skysdottir/Enemy-Within/motherboard hardware/production/bom.csv

Designator | Footprint | Quantity | Value | LCSC Part #
C1, C2, C20, C21, C22 | 0402 | 5 | 1uf
C10, C11, C12, C13, C6, C7, C8, C9 | 0603 | 8 | 47uF
C14, C15, C17, C19, C3 | 0402 | 5 | 100nF
C16 | 0402 | 1 | 10nF
C23, C4, C5 | 0402 | 3 | 10uF
D1 | 0603 | 1 | LED Red
D2 | 0603 | 1 | LED Blue
J2 | JST_XH_B6B-XH-A_1x06_P2.50mm_Vertical | 1 | Conn_01x06_Pin
J3 | MountingHole_2.2mm_M2_Pad_TopBottom | 1 | SMTSO1620MTJ
J4, J5 | PinHeader_1x02_P2.54mm_Vertical | 2 | Conn_01x02_Pin
J6, J8 | PinHeader_1x03_P2.54mm_Vertical | 2 | Conn_01x03_Pin
J7 | PinHeader_1x04_P2.54mm_Vertical | 1 | Conn_01x04_Pin
Q1, Q2, Q3 | DFN3x3A_8L_EP2_S_AOS | 3 | AON7934
R1, R2 | 0402 | 2 | 470R
R10, R13, R14, R7 | 0402 | 4 | 1k
R11, R12, R15, R4, R5, R6, R8, R9 | 0402 | 8 | 10k
R16, R17, R18, R19, R20, R21 | 0402 | 6 | 20r
R3 | 0402 | 1 | 100k
U1 | TSOT-23-5 | 1 | AP2204K-3.3
U2 | VQFN-20-1EP_3x3mm_P0.4mm_EP1.7x1.7mm | 1 | ATtiny1616-M
U3, U4 | WSON-8-1EP_2x2mm_P0.5mm_EP0.9x1.6mm | 2 | DRV8231
U5 | QFN-48-1EP_7x7mm_P0.5mm_EP3.5x3.5mm | 1 | STSPIN32F0ATR
