skysdottir/Enemy-Within/motherboard hardware/enemy-within-motherboard.kicad_pcb

## KiCad design motherboard hardware/enemy-within-motherboard.kicad_pcb (2026-01-28)

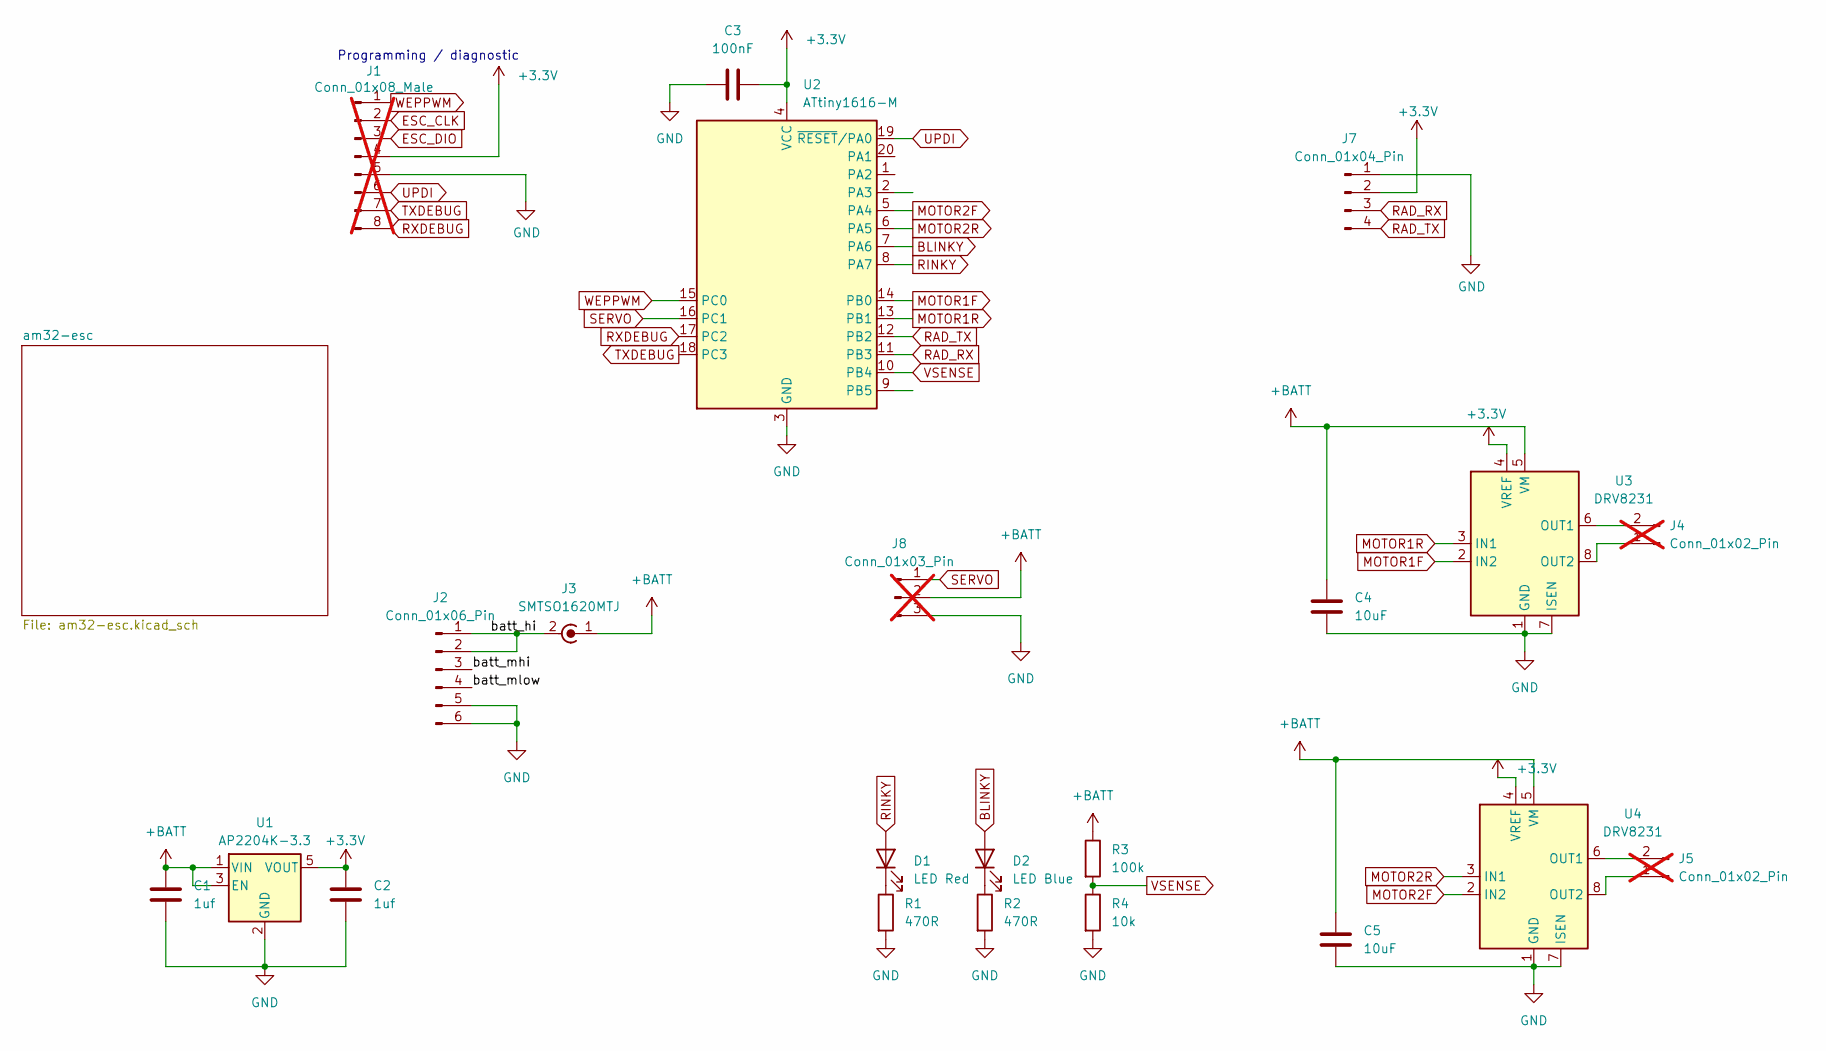
[picture p1: schematic enemy-within-motherboard.kicad_sch]

Parts:
C1, C2: 1uf; C_0402_1005Metric_Pad0.74x0.62mm_HandSolder
C3: 100nF; C_0402_1005Metric_Pad0.74x0.62mm_HandSolder
C4, C5: 10uF; C_0402_1005Metric_Pad0.74x0.62mm_HandSolder
D1: LED Red; LED_0603_1608Metric
D2: LED Blue; LED_0603_1608Metric
J1: Conn_01x08_Male; SOIC_clipProgSmall; not fitted
J2: Conn_01x06_Pin; JST_XH_B6B-XH-A_1x06_P2.50mm_Vertical
J3: SMTSO1620MTJ; MountingHole_2.2mm_M2_Pad_TopBottom
J4, J5: Conn_01x02_Pin; PinHeader_1x02_P2.54mm_Vertical; not fitted
J7: Conn_01x04_Pin; PinHeader_1x04_P2.54mm_Vertical
J8: Conn_01x03_Pin; PinHeader_1x03_P2.54mm_Vertical; not fitted
R1, R2: 470R; R_0402_1005Metric_Pad0.72x0.64mm_HandSolder
R3: 100k; R_0402_1005Metric_Pad0.72x0.64mm_HandSolder
R4: 10k; R_0402_1005Metric_Pad0.72x0.64mm_HandSolder
U1: AP2204K-3.3; TSOT-23-5
U2: ATtiny1616-M; VQFN-20-1EP_3x3mm_P0.4mm_EP1.7x1.7mm
U3, U4: DRV8231; WSON-8-1EP_2x2mm_P0.5mm_EP0.9x1.6mm

Connections:
+3.3V: C2.1, C3.2, J1.4, J7.2, U1.5 (VOUT), U2.4 (VCC), U3.4 (VREF), U4.4 (VREF); also elsewhere on the board
+BATT: C1.1, C4.1, C5.1, J3.1 (In), J8.2, R3.1, U1.1 (VIN), U1.3 (EN), U3.5 (VM), U4.5 (VM); also elsewhere on the board
/batt_hi: J2.1, J2.2, J3.2 (Ext)
/batt_mhi: J2.3
/batt_mlow: J2.4
BLINKY: D2.2 (A), U2.7 (PA6)
ESC_CLK: J1.2; also elsewhere on the board
ESC_DIO: J1.3; also elsewhere on the board
GND: C1.2, C2.2, C3.1, C4.2, C5.2, J1.5, J2.5, J2.6, J7.1, J8.3, R1.2, R2.2, R4.2, U1.2 (GND), U2.3 (GND), U2.21 (GND), U3.1 (GND), U3.7 (ISEN), U3.9 (GND), U4.1 (GND), U4.7 (ISEN), U4.9 (GND); also elsewhere on the board
MOTOR1F: U2.14 (PB0), U3.2 (IN2)
MOTOR1R: U2.13 (PB1), U3.3 (IN1)
MOTOR2F: U2.5 (PA4), U4.2 (IN2)
MOTOR2R: U2.6 (PA5), U4.3 (IN1)
unnamed: D1.1 (K), R1.1
unnamed: D2.1 (K), R2.1
unnamed: J4.1, U3.8 (OUT2)
unnamed: J4.2, U3.6 (OUT1)
unnamed: J5.1, U4.8 (OUT2)
unnamed: J5.2, U4.6 (OUT1)
RAD_RX: J7.3, U2.11 (PB3)
RAD_TX: J7.4, U2.12 (PB2)
RINKY: D1.2 (A), U2.8 (PA7)
RXDEBUG: J1.8, U2.17 (PC2)
SERVO: J8.1, U2.16 (PC1)
TXDEBUG: J1.7, U2.18 (PC3)
UPDI: J1.6, U2.19 (~RESET/PA0)
VSENSE: R3.2, R4.1, U2.10 (PB4); also elsewhere on the board
WEPPWM: J1.1, U2.15 (PC0); also elsewhere on the board

Notes on the sheet:
Programming / diagnostic

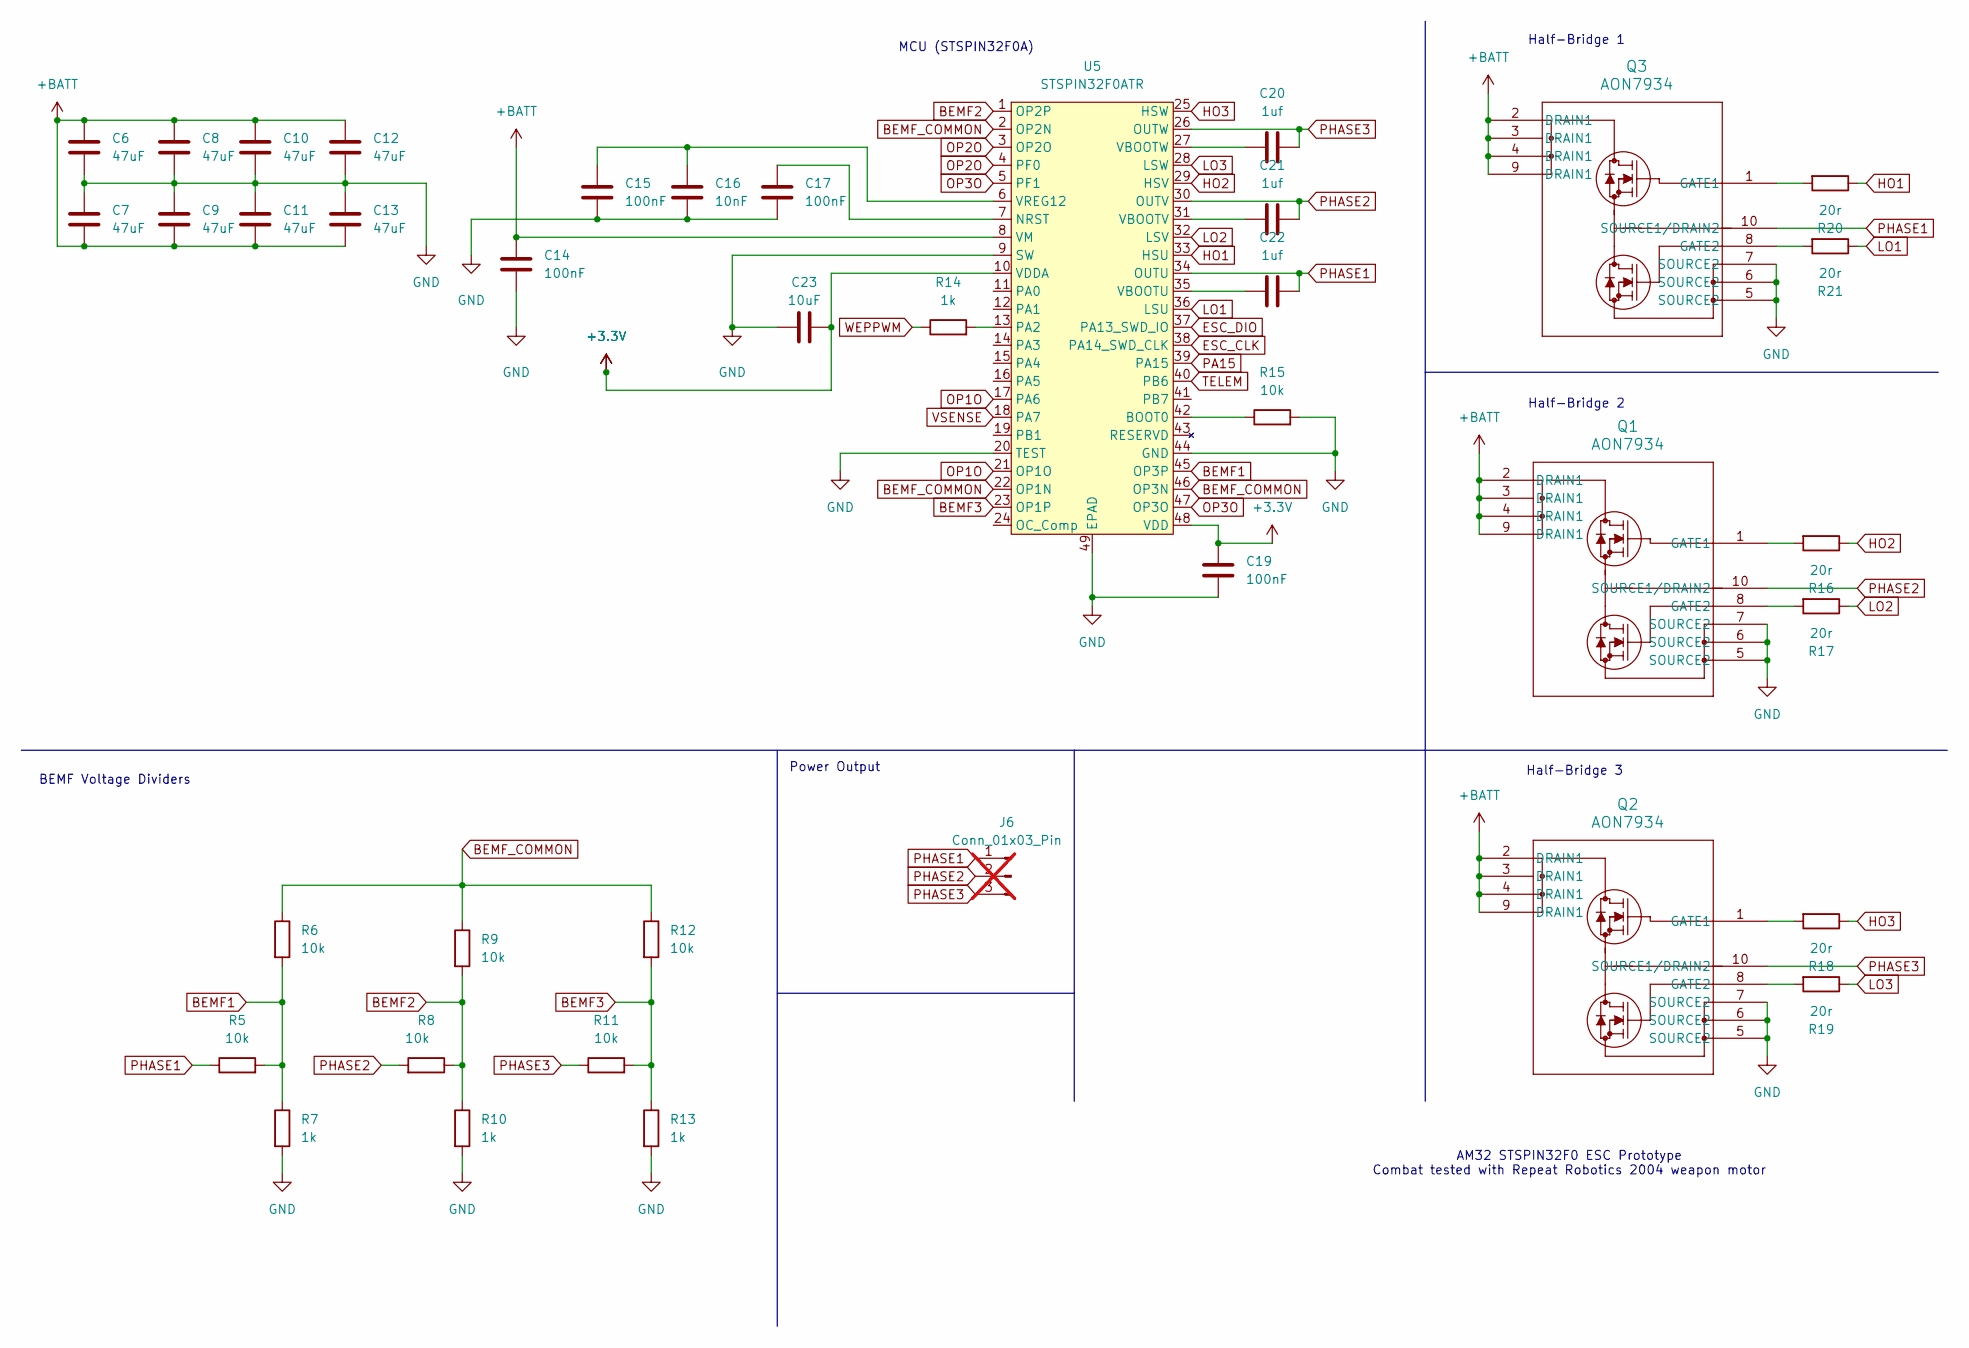
[picture p2: schematic am32-esc.kicad_sch]

Parts:
C6, C7, C8, C9, C10, C11, C12, C13: 47uF; C_0603_1608Metric
C14, C15, C17, C19: 100nF; C_0402_1005Metric_Pad0.74x0.62mm_HandSolder
C16: 10nF; C_0402_1005Metric_Pad0.74x0.62mm_HandSolder
C20, C21, C22: 1uf; C_0402_1005Metric_Pad0.74x0.62mm_HandSolder
C23: 10uF; C_0402_1005Metric_Pad0.74x0.62mm_HandSolder
J6: Conn_01x03_Pin; PinHeader_1x03_P2.54mm_Vertical; not fitted
Q1, Q2, Q3: AON7934; DFN3x3A_8L_EP2_S_AOS
R5, R6, R8, R9, R11, R12, R15: 10k; R_0402_1005Metric_Pad0.72x0.64mm_HandSolder
R7, R10, R13, R14: 1k; R_0402_1005Metric_Pad0.72x0.64mm_HandSolder
R16, R17, R18, R19, R20, R21: 20r; R_0402_1005Metric_Pad0.72x0.64mm_HandSolder
U5: STSPIN32F0ATR; QFN-48-1EP_7x7mm_P0.5mm_EP3.5x3.5mm

Connections:
+3.3V: C19.1, C23.1, U5.10 (VDDA), U5.48 (VDD); also elsewhere on the board
+BATT: C6.1, C7.2, C8.1, C9.2, C10.1, C11.2, C12.1, C13.2, C14.1, Q1.2 (DRAIN1), Q1.3 (DRAIN1), Q1.4 (DRAIN1), Q1.9 (DRAIN1), Q2.2 (DRAIN1), Q2.3 (DRAIN1), Q2.4 (DRAIN1), Q2.9 (DRAIN1), Q3.2 (DRAIN1), Q3.3 (DRAIN1), Q3.4 (DRAIN1), Q3.9 (DRAIN1), U5.8 (VM); also elsewhere on the board
BEMF1: R5.2, R6.2, R7.1, U5.45 (OP3P)
BEMF2: R8.1, R9.2, R10.1, U5.1 (OP2P)
BEMF3: R11.2, R12.2, R13.1, U5.23 (OP1P)
BEMF_COMMON: R6.1, R9.1, R12.1, U5.2 (OP2N), U5.22 (OP1N), U5.46 (OP3N)
ESC_CLK: U5.38 (PA14_SWD_CLK); also elsewhere on the board
ESC_DIO: U5.37 (PA13_SWD_IO); also elsewhere on the board
GND: C6.2, C7.1, C8.2, C9.1, C10.2, C11.1, C12.2, C13.1, C14.2, C15.2, C16.2, C17.2, C19.2, C23.2, Q1.5 (SOURCE2), Q1.6 (SOURCE2), Q1.7 (SOURCE2), Q2.5 (SOURCE2), Q2.6 (SOURCE2), Q2.7 (SOURCE2), Q3.5 (SOURCE2), Q3.6 (SOURCE2), Q3.7 (SOURCE2), R7.2, R10.2, R13.2, R15.2, U5.9 (SW), U5.20 (TEST), U5.44 (GND), U5.49 (EPAD); also elsewhere on the board
HO1: R20.1, U5.33 (HSU)
HO2: R16.1, U5.29 (HSV)
HO3: R18.1, U5.25 (HSW)
LO1: R21.1, U5.36 (LSU)
LO2: R17.1, U5.32 (LSV)
LO3: R19.1, U5.28 (LSW)
unnamed: Q1.1 (GATE1), R16.2
unnamed: Q1.8 (GATE2), R17.2
unnamed: Q2.1 (GATE1), R18.2
unnamed: Q2.8 (GATE2), R19.2
unnamed: Q3.1 (GATE1), R20.2
unnamed: Q3.8 (GATE2), R21.2
unnamed: R15.1, U5.42 (BOOT0)
unnamed: C17.1, U5.7 (NRST)
unnamed: R14.2, U5.13 (PA2)
unnamed: C22.1, U5.35 (VBOOTU)
unnamed: C21.1, U5.31 (VBOOTV)
unnamed: C20.1, U5.27 (VBOOTW)
unnamed: C15.1, C16.1, U5.6 (VREG12)
OP1O: U5.17 (PA6), U5.21 (OP1O)
OP2O: U5.3 (OP2O), U5.4 (PF0)
OP3O: U5.5 (PF1), U5.47 (OP3O)
PA15: U5.39 (PA15)
PHASE1: C22.2, J6.1, Q3.10 (SOURCE1/DRAIN2), R5.1, U5.34 (OUTU)
PHASE2: C21.2, J6.2, Q1.10 (SOURCE1/DRAIN2), R8.2, U5.30 (OUTV)
PHASE3: C20.2, J6.3, Q2.10 (SOURCE1/DRAIN2), R11.1, U5.26 (OUTW)
TELEM: U5.40 (PB6)
VSENSE: U5.18 (PA7); also elsewhere on the board
WEPPWM: R14.1; also elsewhere on the board

Notes on the sheet:
Half-Bridge 3
Half-Bridge 2
AM32 STSPIN32F0 ESC Prototype Combat tested with Repeat Robotics 2004 weapon motor
Half-Bridge 1
Power Output
BEMF Voltage Dividers
MCU (STSPIN32F0A)

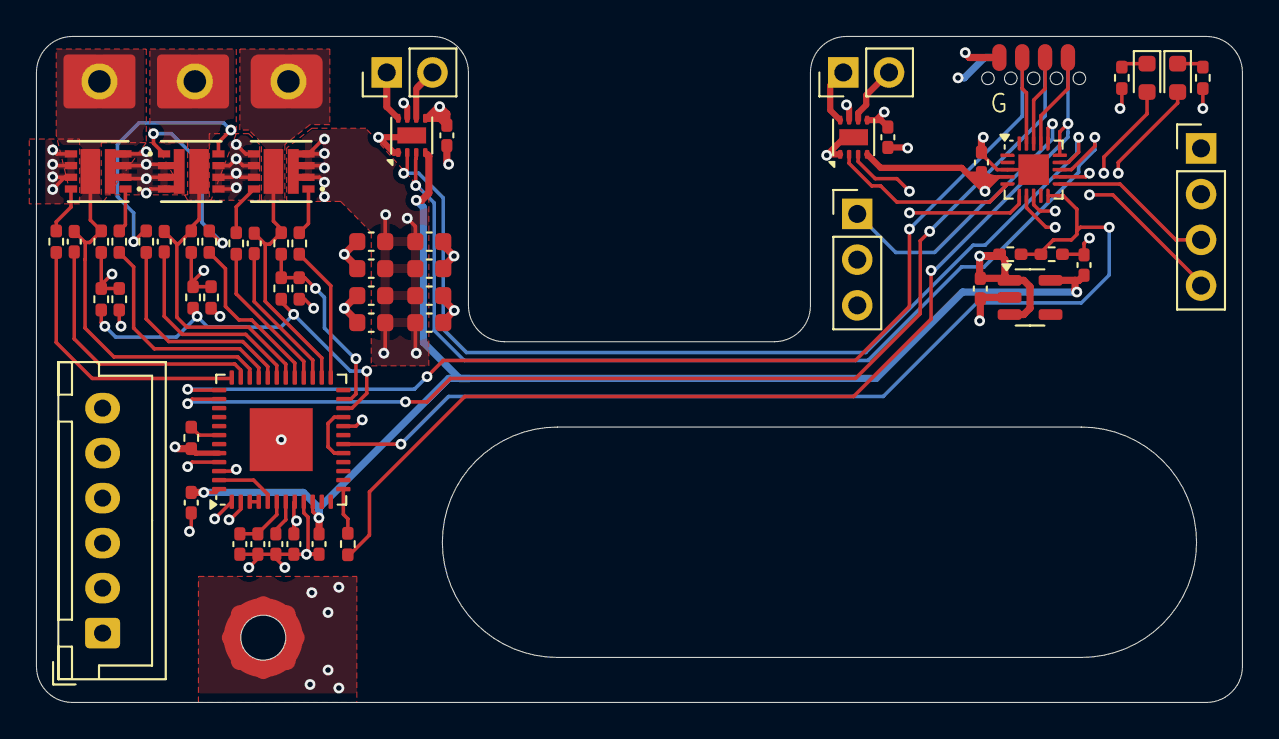
[picture p3: board enemy-within-motherboard.kicad_pcb from above]

Board: 4 copper layers, 67.0 x 37.0 mm, 61 parts (1 on the bottom side), 55 nets.
